wint0178/Modular-Open-Source-Science-Station/docs/images/hardware_preview.html

## WOILD Node v4: Technical Hardware Matrix

From Logical Schematic to Physical Field Infrastructure

1. Electrical Circuit Logic

Circuit Schematic

2. Weatherproof Enclosures Array

Physical Deployment Enclosures

3. PCB Trace Vector (Top Side)

PCB Front Layer Layout

4. PCB Trace Vector (Bottom Side)

PCB Back Layer Layout

Core MCU: Heltec WiFi LoRa 32 V3

Inertial Sensor: MPU6050 Accelerometer

Microclimate Integration: DHT22 Base Core

Power Subsystem: TPS61023 5V Boost
