wint0178/Modular-Open-Source-Science-Station/docs/SUMMARY.md

# Table of Contents

* [Introduction & Overview](README.md)
* [Chapter 1: Hardware & Bill of Materials](ch01-hardware-bom.md)
* [Chapter 2: Home Assistant Setup](ch02-home-assistant.md)
* [Chapter 3.1: Home Assistant Integrations](ch03-home-assistant-integrations.md)
* [Chapter 3.2: Remote Access & Network Architecture](ch03-remote-access.md)
* [Chapter 4.1: MQTT Integration & Payload Processing](ch04-MQTT.md)
* [Chapter 4.2: ESPHome IDE](ch04-esphome.md)
* [Chapter 4.3: TTN & LoRaWAN Integration](ch04-TTN-LoRa.md)
* [Chapter 5: WOILD Firmware Deployment & Payload Architecture](ch05-woild-firmware.md)
* [Chapter 6: Field Deployment & Weather Station Integration](ch06-field-deployment.md)
* [Chapter 7: Field Maintenance, Diagnostics & Troubleshooting](ch07-troubleshooting.md)
* [Appendix: Credits & Disclaimers](appendix.md)
