wint0178/Modular-Open-Source-Science-Station/docs/images/HA-Clima.png

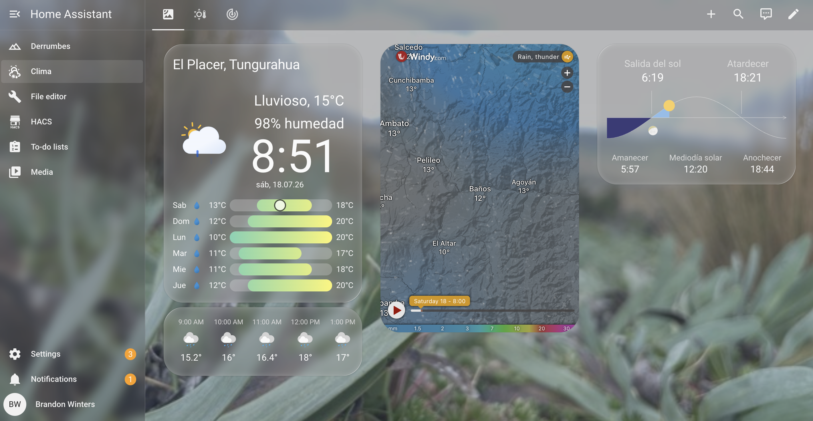
docs/images/HA-Clima.png
