wint0178/Modular-Open-Source-Science-Station/ss-topology-image.png

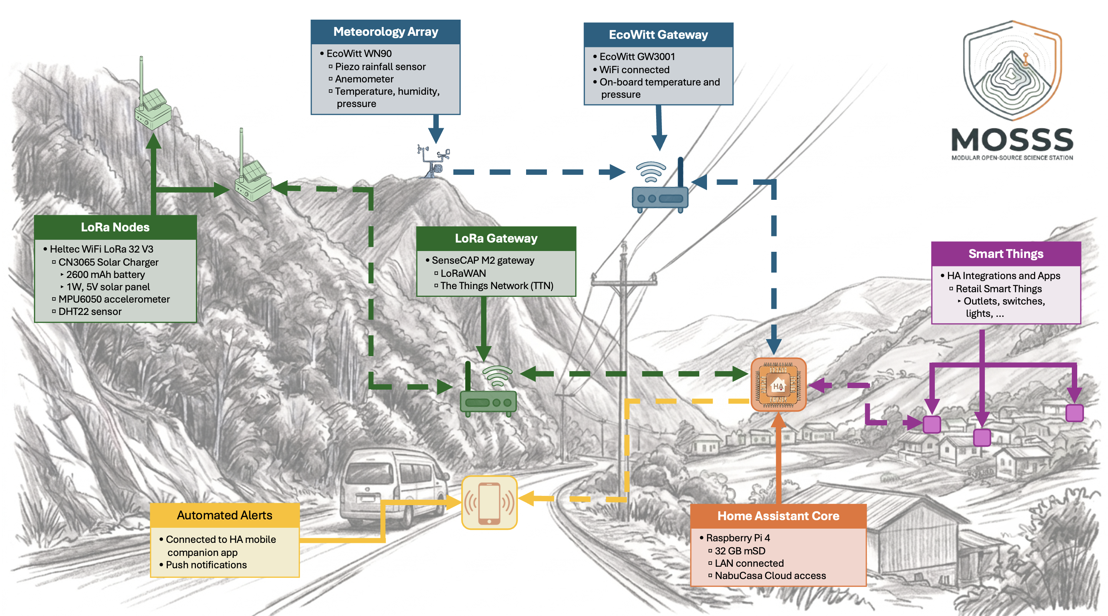
ss-topology-image.png
