wint0178/Modular-Open-Source-Science-Station/docs/ch01-hardware-bom.md

# 🛠️ Chapter 1: MOSSS Hardware Deployment & Bill of Materials (BoM)

This chapter contains the physical infrastructure designs, schematic references, and hardware requirements for the **Modular and Open-Source Science Station (MOSSS)** framework. 

To deploy a standard operational tracking cell, you will need components for three distinct layers: the physical telemetry edge nodes (WOILD), the microclimate parsing node (EcoWitt), and the localized gateway hub.

---

## 📋 Comprehensive Bill of Materials (BoM)

### 1. WOILD Edge Nodes (Per Node)
These low-power field units are custom-fabricated to monitor earth movement and acceleration over remote slopes. Total cost per node is about $70.00.

| Component | Quantity | Description / Function | Key Specification | Est. Unit Cost (USD) |
|---|---|---|---|---|
| [**MCU Development Board**](https://www.amazon.com/V3-ESP32-Development-Dual-core-Meshtastic/dp/B0DRSJV1ZL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) | 1 | Core microprocessor processing telemetry and deep-sleep states. | Heltec WiFi LoRa 32 V3 (Must support external RTC GPIO interrupts) | $20.00 |
| [**Inclinometer / Accelerometer**](https://www.amazon.com/HiLetgo-MPU-6050-Accelerometer-Gyroscope-Converter/dp/B00LP25V1A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) | 1 | Senses ground acceleration and shifts; outputs low-pulse hardware interrupt. | MPU6050 breakout board | $4.00 |
| [**Custom 2-Layer PCB**](https://oshpark.com/) | 1 | Integrates MCU, power regulation, and sensor lines (See gerber files). | FR-4 substrate, ENIG finish (highly recommended for high humidity) | $15.00 |
| [**Power Storage**](https://www.amazon.com/Rechargeable-Battery-PH2-0-Speakers-Packs/dp/B0F1D5HVJ8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) | 1 | High-capacity outdoor power delivery. | 3.7V 18650 Li-ion battery (2500mAh+), with 2 pin, 2.54 mm pitch JST | $10.00 |
| [**Solar Harvesting**](https://www.amazon.com/Panels-Electric-Materials-Photovoltaic-System/dp/B0B8YHP7NR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) | 1 | Charges internal cells under light canopy tracking conditions. | 5V 1W to 2W Monocrystalline solar panel | $3.00 |
| [**Humidity Sensor**](https://www.amazon.com/SATUY-DHT22-AM2302-Temperature-Electronic/dp/B0FCLX5GTZ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) | 1 | Detects water in enclosure. | DHT22 breakout board | $2.00 |
| [**Solar Charger**](https://www.amazon.com/ACEIRMC-Charger-Lithium-Application-Charging/dp/B0DXZ5CWXQ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) | 1 | Manages solar power and battery charging. | CN3065 solar charge board | $2.00 |
| [**Enclosure**](https://www.amazon.com/Zulkit-Dustproof-Waterproof-Electrical-150x100x70mm/dp/B08KY7VK8W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) | 1 | Ruggedized environmental protection box. | IP67/IP68 weatherproof junction box with cable glands | $5.00 - $10.00 |
| [**4.7 kOhm resistor**](https://www.amazon.com/EDGELEC-Resistor-Tolerance-Resistance-Optional/dp/B07HDFHPP3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) | 2 | Used to pull up SDA and SCL pins for I2C | Must solder to through holes of PCB | $0.10 |
| [**Female Header Pins**](https://www.amazon.com/Ferwooh-Single-Straight-Connector-Spacing/dp/B0CZ6X313F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) | 3 | Soldered to PCB to accept boards | 40 pin, 2.54 mm pitch | $0.75 |
| [**Screw Terminal Block**](https://www.amazon.com/Screw-Terminal-Block-Circuit-Connectors/dp/B0FNQX9MMT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) | 2 | Solder to PCB for solar and tripwire | 2 pin, 5 mm | $0.25 |
| [**JST Battery Connector**](https://www.amazon.com/Letool%C2%AE30-1-25mm-Female-Connector-Cables/dp/B013JRWCBU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) | 1 | Solder to CN3065 for battery connection | 2 pin, 1.25 mm pitch | $0.30 |
| [**22 AWG Wire**](https://www.amazon.com/Conductor-Electrical-Parallel-0-3mm%C2%B2%EF%BC%8C-Projects/dp/B0FH4YYJ3Y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) | 1 | Solder to solar pannel | 2 Conductor, tinned, 10 meters | $10.00 |
| [**Tripwire**](https://www.amazon.com/dp/B003NN1XZM?th=1) | 1 | Disconnected audio port serves as tripwire | 1/8" audio TRS extender, 6 ft | $2.00 |

### 2. Meteorological Subsystem (Per Site)
Aggregates hyper-local microclimate data and makes them available online.

| Component | Description / Function | Key Specification | Est. Unit Cost (USD) |
|---|---|---|---|
| [**EcoWitt Weather Station**](https://www.amazon.com/ECOWITT-Ethernet-Humidity-Anemometer-Barometric/dp/B0DTPXKP8B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) | Solid-state array and WiFi Gateway | GW3000 with WS90 7-in-1 Sensor Array | $200.00 |

### 3. Central Gateway Hub (Per Grid)
The edge-computing collection facility responsible for the GUI, data collection and distribution, LoRa transmission accumulation, and automated emergency alerts.

| Component | Description / Function | Key Specification | Est. Unit Cost (USD) |
|---|---|---|---|
| [**Edge Server Platform**](https://www.amazon.com/CanaKit-Raspberry-4GB-Starter-Kit/dp/B07V5JTMV9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) | Dedicated machine running Home Assistant. | Raspberry Pi 4 (4GB+)| $160.00 |
| [**LoRaWAN Gateway**](https://www.amazon.com/dp/B0CG98XDLX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) | Acts as the local network concentrator to intercept WOILD node signals. | SenseCAP M2 indoor LoRa gateway or similar multichannnel gateway | $70.00 - $120.00 |

---

## 🔌 Critical Circuit Interconnect Requirements

To successfully leverage the ultra-low-power **Wake on Interrupt** performance characteristics of the WOILD node ($<700\mu\text{A}$ current draw while asleep), verify your PCB layout complies with the following trace paths:

1. **The Interrupt Rail:** Connect the **`INT`** pin of your accelerometer module directly to an **RTC-capable GPIO pin** on the microprocessor board (e.g., GPIO 12, 14, or 15 on a standard ESP32). Non-RTC pins cannot capture states when the core processor clock is powered down.
2. **I2C Interface:** Establish direct lines from `SDA` and `SCL` pins with appropriate $4.7\text{k}\Omega$ pull-up resistors to maintain baseline data stability when checking telemetry frames.
3. **Power-Gating Transistors:** Implement a P-channel MOSFET network to cut off parasitic current leaking into the LoRa module during deep-sleep monitoring intervals.

PCB MANUFACTURING & ORDERING GUIDE
==============================================================================

This [directory](https://github.com/wint0178/Modular-Open-Source-Science-Station/tree/main/hardware/PCB-Gerbers/LD%20PCB%20V3/) contains the production-ready Gerber files exported from KiCad 
for the Multi-Node Landslide Detection hardware. You can use the included 
ZIP archive to order custom printed circuit boards from any standard quick-turn 
PCB fabrication house.

------------------------------------------------------------------------------
RECOMMENDED FABRICATION HOUSES
------------------------------------------------------------------------------
The exported files use standard RS-274X/X2 formats, compatible with all major 
global manufacturers. Popular high-quality options include:
  * JLCPCB (jlcpcb.com)
  * PCBWay (pcbway.com)
  * OSH Park (oshpark.com) - Perfect for high-precision, US-made prototypes

## 🛠️ WOILD Node v4 Hardware Design

The hardware subsystem is engineered to bridge abstract telemetry logic with resilient environmental deployment. The panel matrix below tracks our complete progression from the baseline circuit traces to our physical field installation array.

<table>
  <tr>
    <td>
      <div style="font-weight: bold; font-size: 12px; text-transform: uppercase; font-family: sans-serif; margin-bottom: 4px;">1. Circuit Logic</div>
      Circuit Schematic
    </td>
    <td>
      <div style="font-weight: bold; font-size: 12px; text-transform: uppercase; font-family: sans-serif; margin-bottom: 4px;">2. Enclosures</div>
      Physical Deployment Enclosures
    </td>
  </tr>
  <tr>
    <td>
      <div style="font-weight: bold; font-size: 12px; text-transform: uppercase; font-family: sans-serif; margin-top: 10px; margin-bottom: 4px;">3. PCB Top Side</div>
      PCB Front Layer Layout
    </td>
    <td>
      <div style="font-weight: bold; font-size: 12px; text-transform: uppercase; font-family: sans-serif; margin-top: 10px; margin-bottom: 4px;">4. PCB Bottom Side</div>
      PCB Back Layer Layout
    </td>
  </tr>
</table>

------------------------------------------------------------------------------
STEP-BY-STEP ORDERING INSTRUCTIONS
------------------------------------------------------------------------------

  1. Locate the Archive:
     * Find and download the bundled Gerber zip file in this [directory](https://github.com/wint0178/Modular-Open-Source-Science-Station/tree/main/hardware/PCB-Gerbers/). Do NOT unzip it.

  2. Upload to the Fabricator:
     * Navigate to your chosen manufacturer's website and click on their 
       "PCB Instant Quote" or "Order Now" tool.
     * Drag and drop the untouched .zip file directly into their online Gerber 
       viewer upload box.

  3. Verify the Upload:
     * Most modern fabricators will automatically parse the zip archive and 
       display a live visual preview of the top and bottom layers of the board.
     * Ensure the board dimensions are automatically and correctly detected 
       by the online system.

------------------------------------------------------------------------------
RECOMMENDED FABRICATION SPECIFICATIONS (PRODUCTION SETTINGS)
------------------------------------------------------------------------------
When completing the configuration form on the manufacturer's website, use the 
following baseline settings to ensure physical reliability in outdoor terrain:

  * Material Type: FR-4 (Standard)
  * Layer Count: 2 Layers (Double-sided)
  * PCB Thickness: 1.6 mm (Standard thickness for rugged field enclosures)
  * Surface Finish: HASL with lead (Cost-effective) OR ENIG (Electroless Nickel 
    Immersion Gold). 
    --> NOTE: ENIG is strongly recommended if you are deploying nodes in highly 
        humid, tropical environments, as it offers superior oxidation resistance.
  * Copper Weight: 1 oz (Standard)
  * Solder Mask Color: Your choice (Green, Blue, Black, etc. Does not affect performance)
  * Silkscreen Color: White (Or contrasting color for component label readability)

------------------------------------------------------------------------------
COMPONENT SOURCING (BoM & CPL)
------------------------------------------------------------------------------
  * Component Placement: The board layout utilizes clear silkscreen labeling 
    identifying resistor, capacitor, microcontroller, and sensor pinouts.
  * Assembly: This board is optimized for hand-soldering. If you intend to use 
    an automated turn-key assembly service (PCBA), you will need to provide the 
    manufacturer with the Bill of Materials (BoM) and Component Placement List 
    (CPL / Centroid file) exported separately from the main design repository.
==============================================================================

👉 **Proceed to [Chapter 2: Home Assistant Setup](./ch02-home-assistant.md)**
