wint0178/Modular-Open-Source-Science-Station/(commit log)

2026-07-18 Update README.md formatting for PCB Gerbers
2026-07-18 Revise README.md for PCB Gerbers layout and style
    Updated styling and layout for hardware design documentation.
2026-07-18 Fix link text for OS-Provisioning stage
2026-07-18 Update link text for Stage 3 navigation
2026-08-17 updated prices in BoM
2026-08-17 updated BoM
2026-08-17 added BoM links
2026-08-17 updated BoM prices
